GadgetReboot/Guitar_Pedal_Interface/README.md

# Guitar_Pedal_Interface
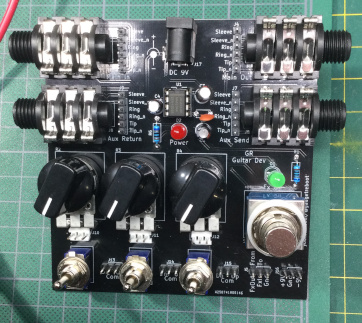
[picture p1: Assembled_PCB.jpg]
PCB
<br><br><BR><BR>
Guitar jacks, stomp switch, pots, toggle switches and a -9v supply generator from +9v in for guitar effect prototyping.
