GadgetReboot/Guitar_Pedal_Interface/Sch_Guitar_Fx_Dev.pdf

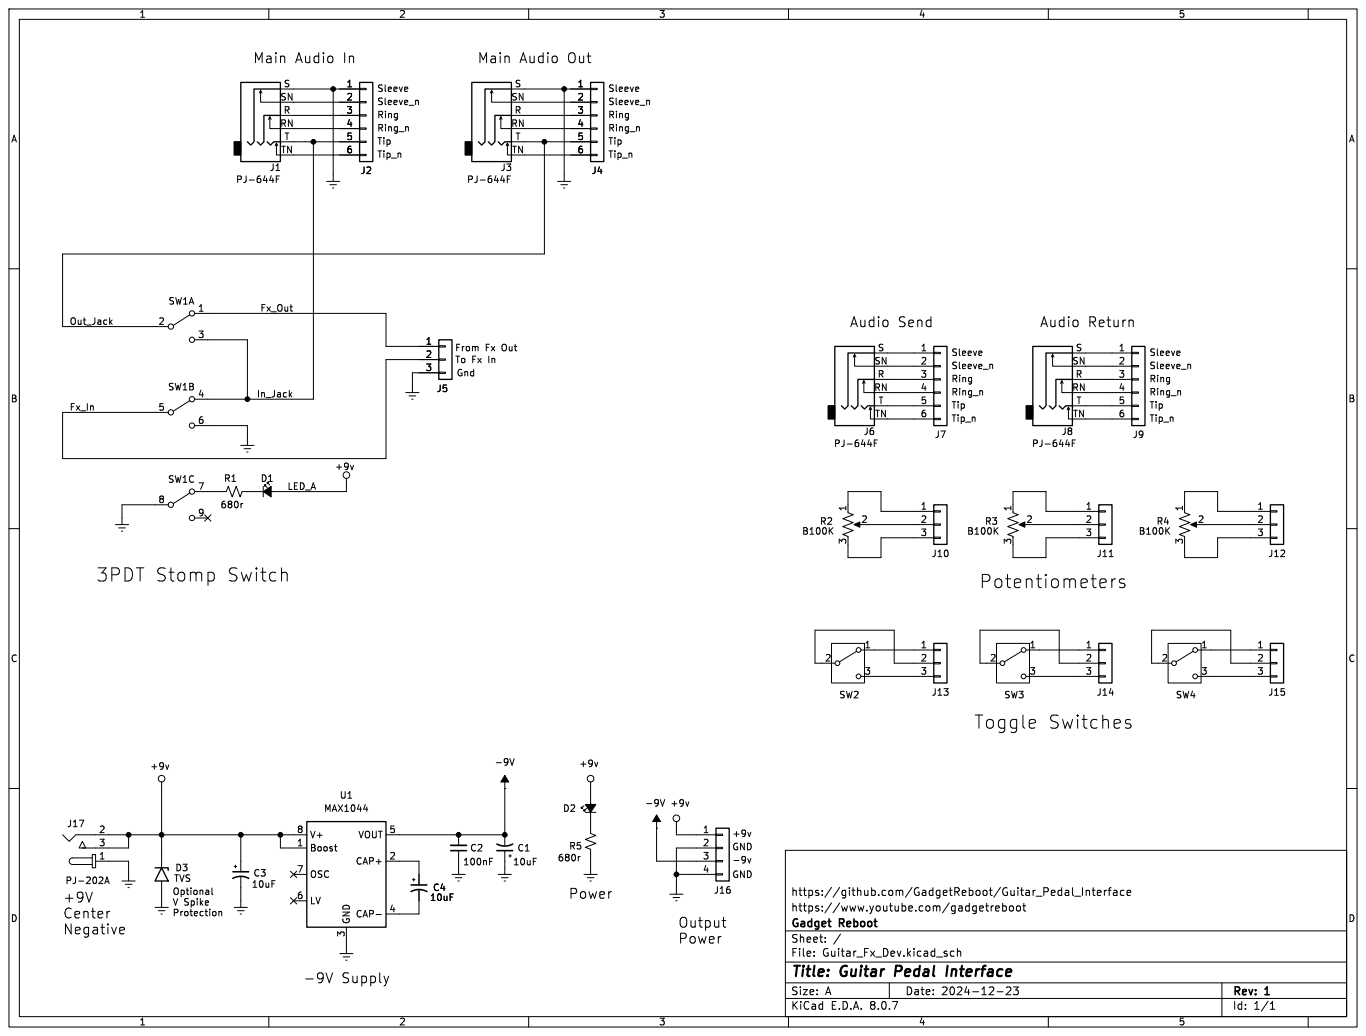
[picture p2: page 1]

https://github.com/GadgetReboot/Guitar_Pedal_Interface

Id: 1/1 Title: Guitar Pedal Interface
