GadgetReboot/Guitar_Pedal_Interface/KiCad/Guitar_Fx_Dev.kicad_pcb

## KiCad design KiCad/Guitar_Fx_Dev.kicad_pcb (2025-01-23)

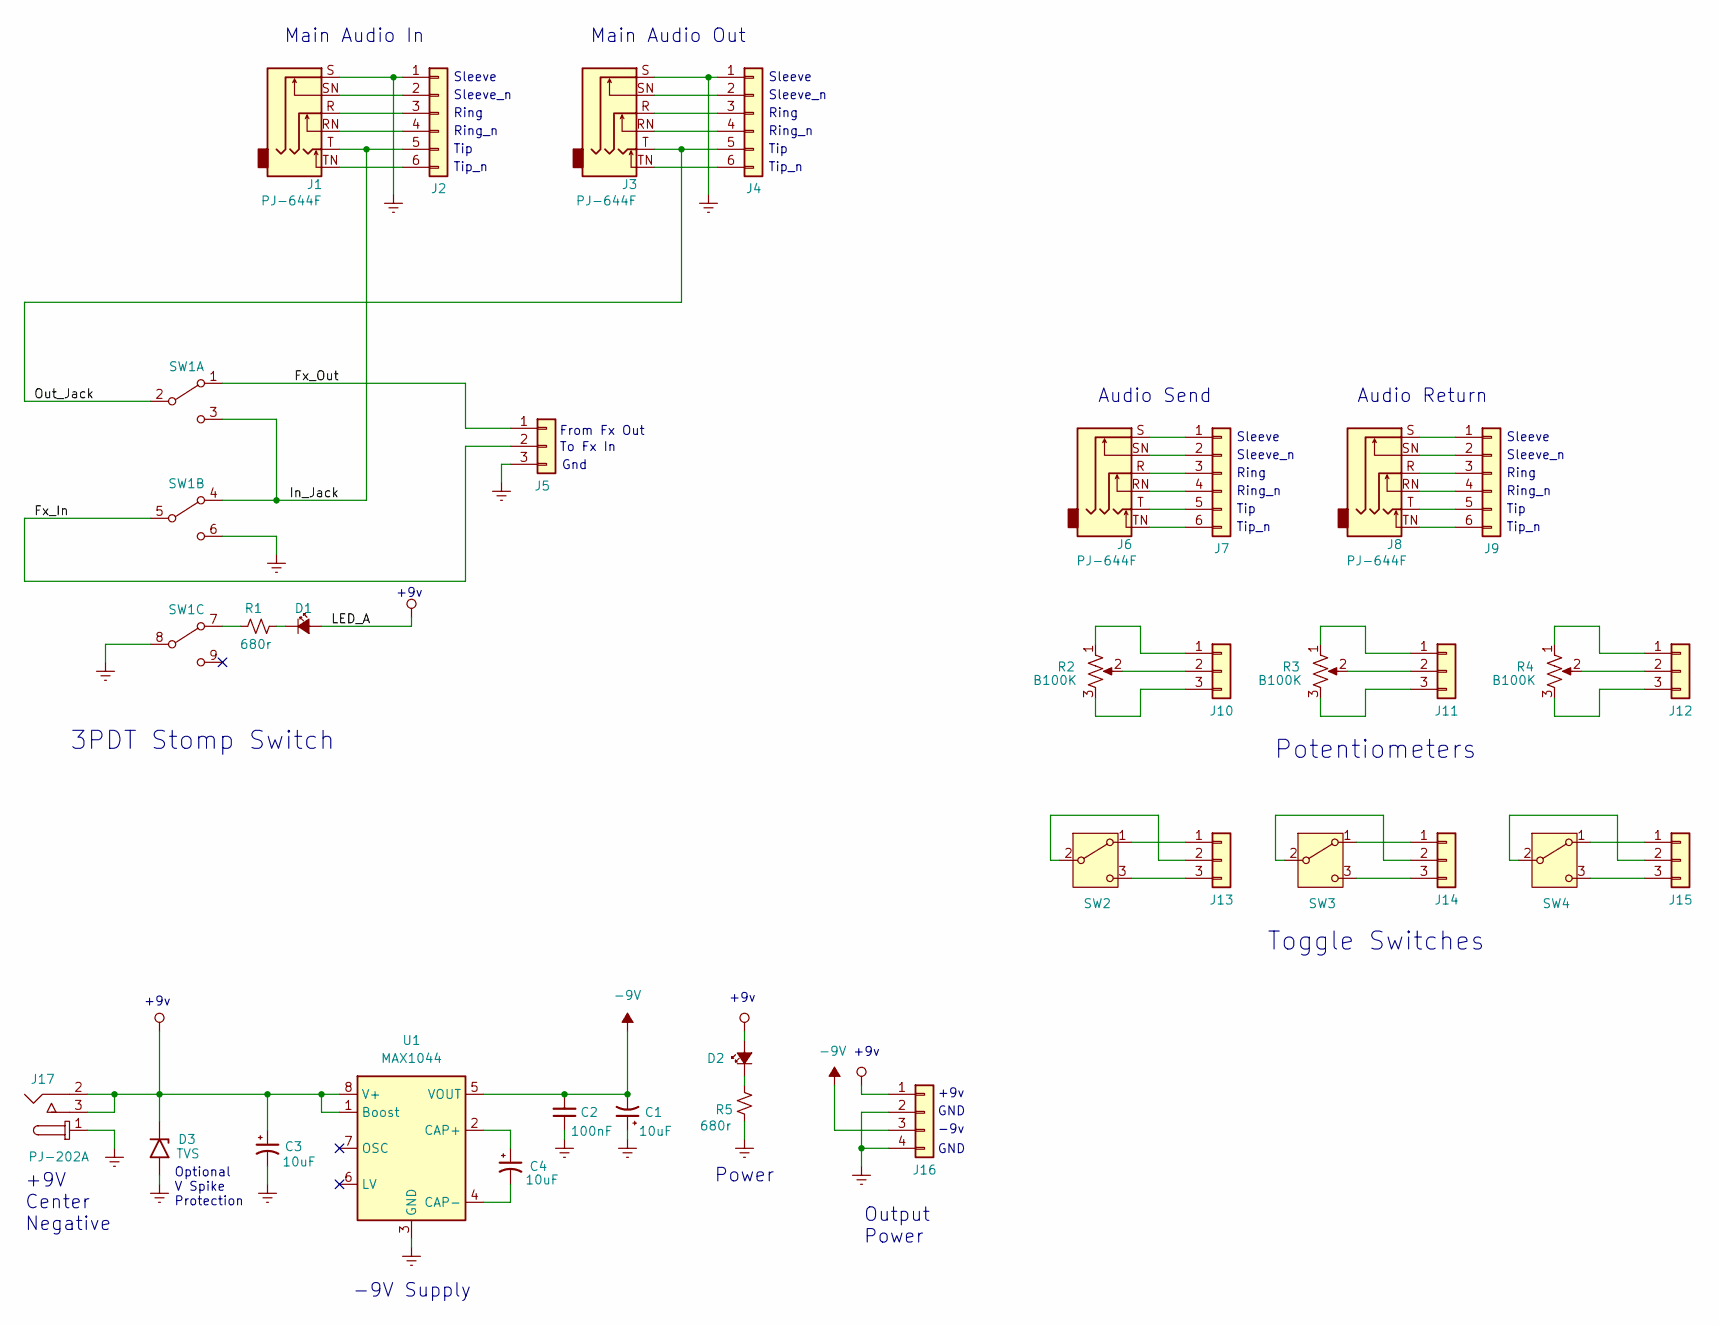
[picture p3: schematic Guitar_Fx_Dev.kicad_sch, Guitar Pedal Interface]

Parts:
C1, C3, C4: 10uF; CP_Radial_D5.0mm_P2.50mm
C2: 100nF; C_Disc_D4.7mm_W2.5mm_P5.00mm
D1, D2: LED_Small_ALT; LED_D5.0mm
D3: TVS; D_DO-15_P12.70mm_Horizontal
J1, J3, J6, J8: PJ-644F; Jack_6.35mm_Neutrik_NMJ6HFD2_Horizontal
J2, J4, J7, J9: Conn_01x06; PinHeader_1x06_P2.54mm_Vertical
J5, J10, J11, J12, J13, J14, J15: Conn_01x03; PinHeader_1x03_P2.54mm_Vertical
J16: Conn_01x04; PinHeader_1x04_P2.54mm_Vertical
J17: PJ-202A; Barrel_Jack_5.5mmODx2.1mmID_PJ-202A; MPN PJ-202A; Digi-Key_PN CP-202A-ND
R1, R5: 680r; R_Axial_DIN0207_L6.3mm_D2.5mm_P10.16mm_Horizontal
R2, R3, R4: B100K; Potentiometer_Vimex
SW1: SW_3PDT; STOMP-SWITCH-3PDT
SW2, SW3, SW4: Adam Tech SW-T2-2E-A-A2-M1; Toggle_Sw_SPDT
U1: MAX1044; DIP-8_W7.62mm

Connections:
-9V: C1.2, C2.2, J16.3, U1.5 (VOUT)
/Fx_In: J5.2, SW1.5 (B)
/Fx_Out: J5.1, SW1.1 (A)
/In_Jack: J1.T, J2.5, SW1.3 (C), SW1.4 (A)
/Out_Jack: J3.T, J4.5, SW1.2 (B)
GNDREF: C1.1, C2.1, C3.2, D3.2 (A2), J1.S, J2.1, J3.S, J4.1, J5.3, J16.2, J16.4, J17.1, R5.2, SW1.6 (C), SW1.8 (B), U1.3 (GND)
unnamed: D1.1 (K), R1.1
unnamed: D2.1 (K), R5.1
unnamed: J1.SN, J2.2
unnamed: J1.R, J2.3
unnamed: J1.RN, J2.4
unnamed: J1.TN, J2.6
unnamed: J3.SN, J4.2
unnamed: J3.R, J4.3
unnamed: J3.RN, J4.4
unnamed: J3.TN, J4.6
unnamed: J6.S, J7.1
unnamed: J6.SN, J7.2
unnamed: J6.R, J7.3
unnamed: J6.RN, J7.4
unnamed: J6.T, J7.5
unnamed: J6.TN, J7.6
unnamed: J8.S, J9.1
unnamed: J8.SN, J9.2
unnamed: J8.R, J9.3
unnamed: J8.RN, J9.4
unnamed: J8.T, J9.5
unnamed: J8.TN, J9.6
unnamed: J10.1, R2.1
unnamed: J10.2, R2.2
unnamed: J10.3, R2.3
unnamed: J11.1, R3.1
unnamed: J11.2, R3.2
unnamed: J11.3, R3.3
unnamed: J12.1, R4.1
unnamed: J12.2, R4.2
unnamed: J12.3, R4.3
unnamed: J13.1, SW2.1 (A)
unnamed: J13.2, SW2.2 (B)
unnamed: J13.3, SW2.3 (C)
unnamed: J14.1, SW3.1 (A)
unnamed: J14.2, SW3.2 (B)
unnamed: J14.3, SW3.3 (C)
unnamed: J15.1, SW4.1 (A)
unnamed: J15.2, SW4.2 (B)
unnamed: J15.3, SW4.3 (C)
unnamed: R1.2, SW1.7 (A)
unnamed: C4.1, U1.2 (CAP+)
unnamed: C4.2, U1.4 (CAP-)
VCC: C3.1, D1.2 (A), D2.2 (A), D3.1 (A1), J16.1, J17.2, J17.3, U1.1 (Boost), U1.8 (V+)

Notes on the sheet:
Sleeve_n
+9v
Output Power
Toggle Switches
Ring_n
Ring
To Fx In
Sleeve
Potentiometers
Power
-9V Supply
Tip_n
3PDT Stomp Switch
Audio Send
From Fx Out
Gnd
GND
Tip
-9v
Main Audio In
Optional V Spike Protection
+9V Center Negative
Main Audio Out
Audio Return

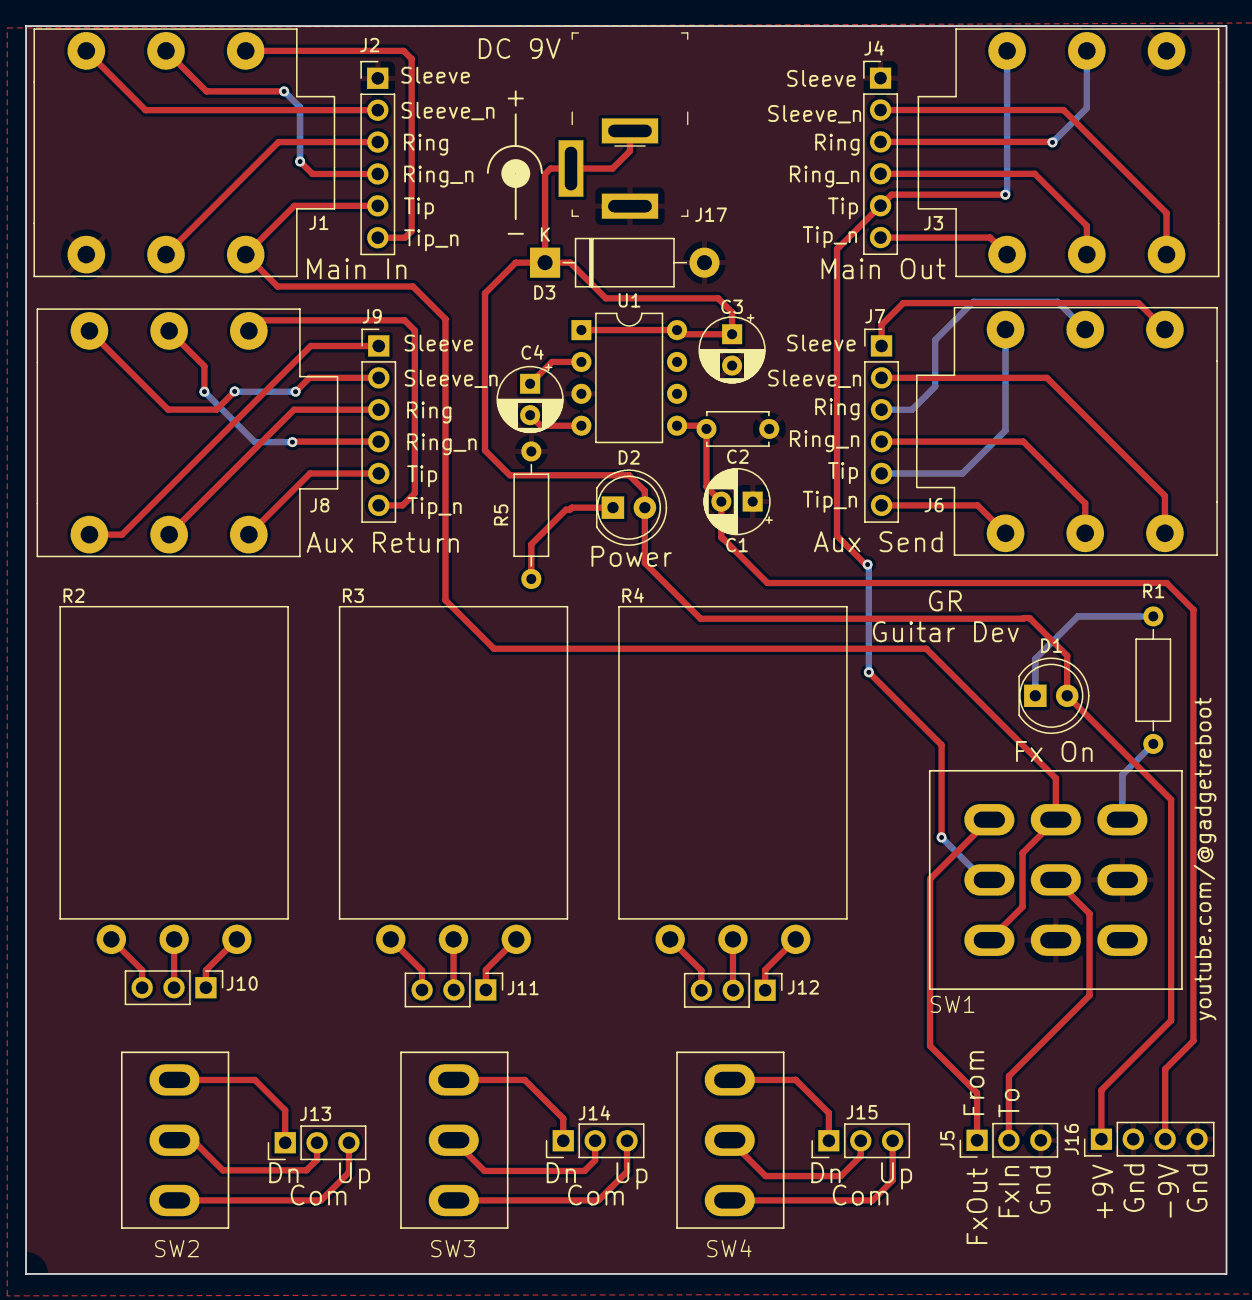
[picture p4: board Guitar_Fx_Dev.kicad_pcb from above]

Board: 2 copper layers, 95.6 x 99.4 mm, 34 parts (0 on the bottom side), 50 nets.
